klouderone/Kiwi36-Split/Kiwi36 PCB Kicad Files/kiwi_36.kicad_sch

## KiCad design Kiwi36 PCB Kicad Files/kiwi_36.kicad_sch (2025-06-20)

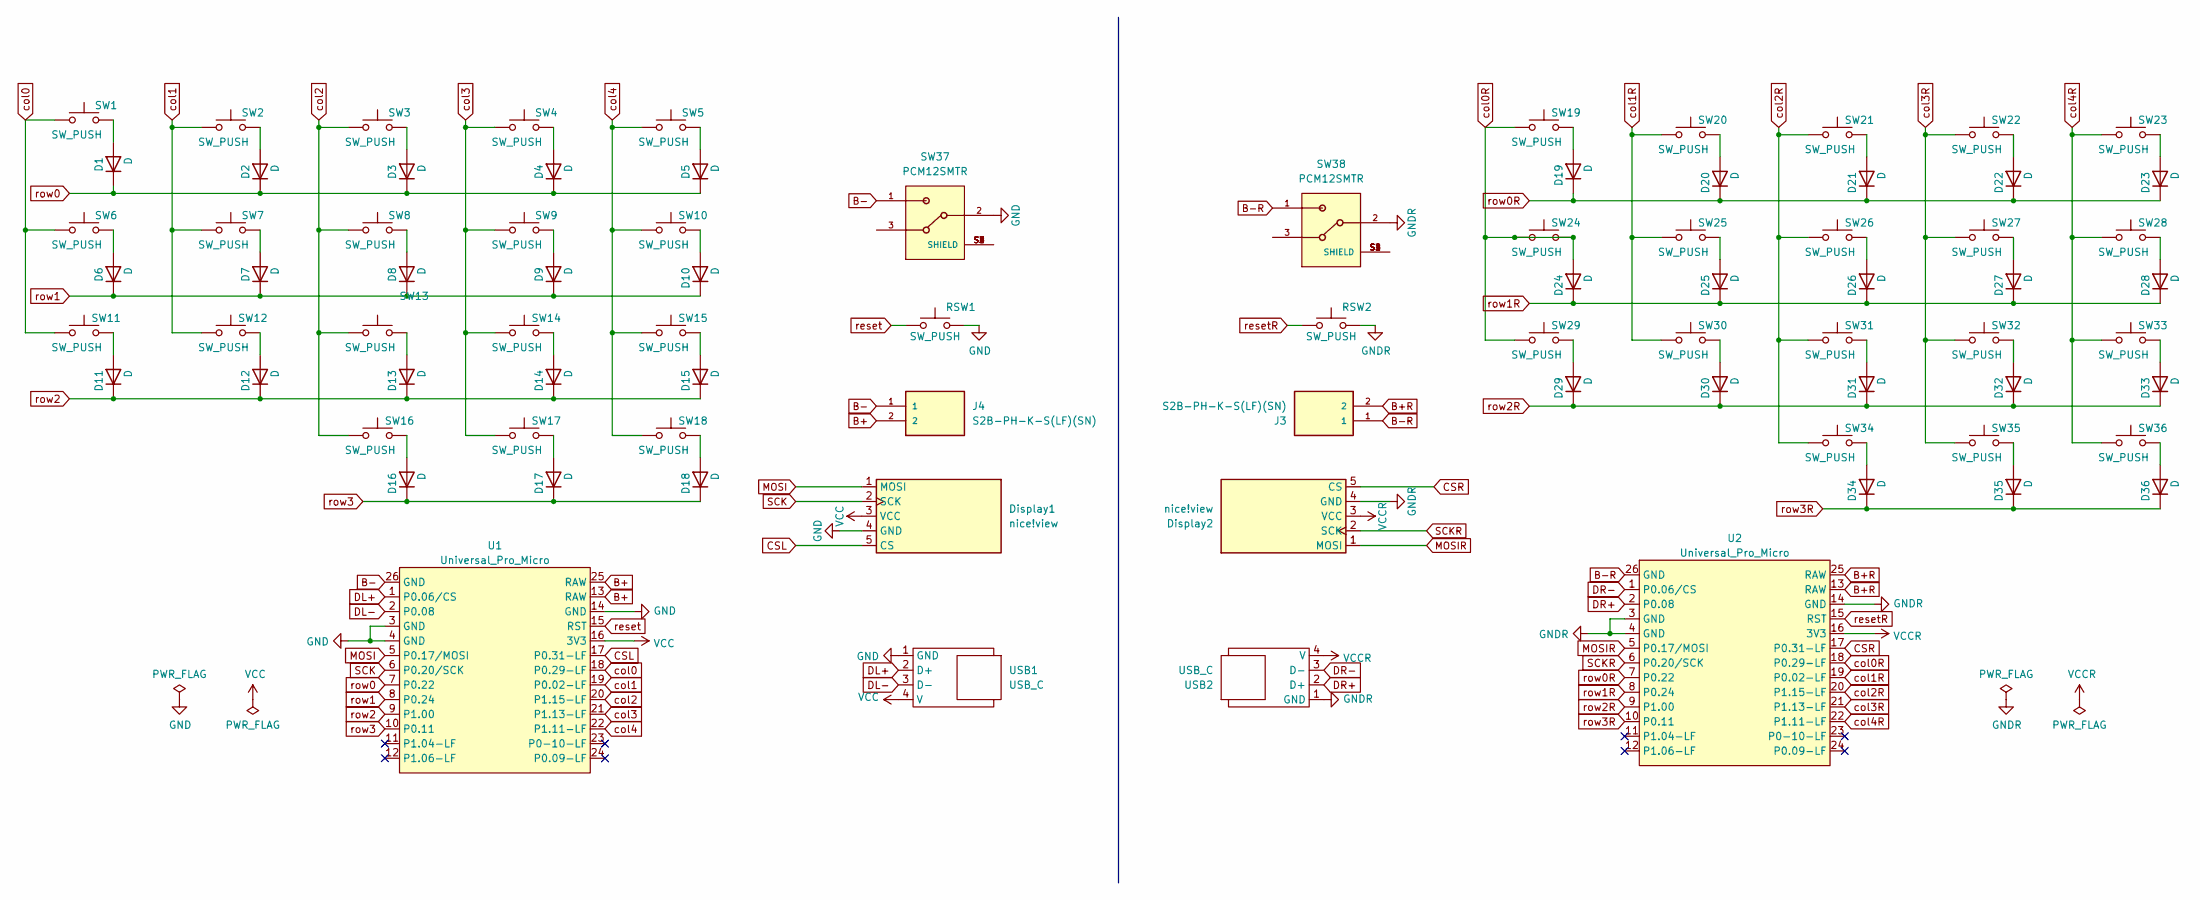
[picture p1: schematic kiwi_36.kicad_sch]

Parts:
D1, D2, D3, D4, D5, D6, D7, D8, D9, D10, D11, D12, D13, D14, D15, D16, D17, D18, D19, D20, D21, D22, D23, D24, D25, D26, D27, D28, D29, D30, D31, D32, D33, D34, D35, D36: D; SMD SOD123 and Leaded
Display1, Display2: nice!view; nice_view
J3, J4: S2B-PH-K-S(LF)(SN); PH_S2B-PH2-K_1x02_P2.00mm_Horizontal
RSW1, RSW2: SW_PUSH; ResetSW_1side
SW1, SW2, SW3, SW4, SW5, SW6, SW7, SW8, SW9, SW10, SW11, SW12, SW13, SW14, SW15, SW16, SW17, SW18, SW19, SW20, SW21, SW22, SW23, SW24, SW25, SW26, SW27, SW28, SW29, SW30, SW31, SW32, SW33, SW34, SW35, SW36: SW_PUSH; SW_MXchocGLP_HS_1u
SW37, SW38: PCM12SMTR; MSK-12C02 Toggle Switch
U1, U2: Universal_Pro_Micro; Universal_Pro_Micro_Footprint
USB1, USB2: USB_C; USB C Daugher Board

Connections:
B+: J4.2, U1.13 (RAW), U1.25 (RAW)
B+R: J3.2, U2.13 (RAW), U2.25 (RAW)
B-: J4.1, SW37.1, U1.26 (GND)
B-R: J3.1, SW38.1, U2.26 (GND)
CSL: Display1.5 (CS), U1.17 (P0.31-LF)
CSR: Display2.5 (CS), U2.17 (P0.31-LF)
DL+: U1.1 (P0.06/CS), USB1.2 (D+)
DL-: U1.2 (P0.08), USB1.3 (D-)
DR+: U2.2 (P0.08), USB2.2 (D+)
DR-: U2.1 (P0.06/CS), USB2.3 (D-)
GND: Display1.4 (GND), RSW1.2, SW37.2, U1.3 (GND), U1.4 (GND), U1.14 (GND), USB1.1 (GND)
GNDR: Display2.4 (GND), RSW2.2, SW38.2, U2.3 (GND), U2.4 (GND), U2.14 (GND), USB2.1 (GND)
MOSI: Display1.1 (MOSI), U1.5 (P0.17/MOSI)
MOSIR: Display2.1 (MOSI), U2.5 (P0.17/MOSI)
unnamed: D1.2 (A), SW1.2
unnamed: D2.2 (A), SW2.2
unnamed: D3.2 (A), SW3.2
unnamed: D4.2 (A), SW4.2
unnamed: D5.2 (A), SW5.2
unnamed: D6.2 (A), SW6.2
unnamed: D7.2 (A), SW7.2
unnamed: D8.2 (A), SW8.2
unnamed: D9.2 (A), SW9.2
unnamed: D10.2 (A), SW10.2
unnamed: D11.2 (A), SW11.2
unnamed: D12.2 (A), SW12.2
unnamed: D13.2 (A), SW13.2
unnamed: D14.2 (A), SW14.2
unnamed: D15.2 (A), SW15.2
unnamed: D16.2 (A), SW16.2
unnamed: D17.2 (A), SW17.2
unnamed: D18.2 (A), SW18.2
unnamed: D19.2 (A), SW19.2
unnamed: D20.2 (A), SW20.2
unnamed: D21.2 (A), SW21.2
unnamed: D22.2 (A), SW22.2
unnamed: D23.2 (A), SW23.2
unnamed: D25.2 (A), SW25.2
unnamed: D26.2 (A), SW26.2
unnamed: D27.2 (A), SW27.2
unnamed: D28.2 (A), SW28.2
unnamed: D29.2 (A), SW29.2
unnamed: D30.2 (A), SW30.2
unnamed: D31.2 (A), SW31.2
unnamed: D32.2 (A), SW32.2
unnamed: D33.2 (A), SW33.2
unnamed: D34.2 (A), SW34.2
unnamed: D35.2 (A), SW35.2
unnamed: D36.2 (A), SW36.2
unnamed: SW37.S1 (SHIELD), SW37.S2 (SHIELD), SW37.S3 (SHIELD), SW37.S4 (SHIELD)
unnamed: SW38.S1 (SHIELD), SW38.S2 (SHIELD), SW38.S3 (SHIELD), SW38.S4 (SHIELD)
SCK: Display1.2 (SCK), U1.6 (P0.20/SCK)
SCKR: Display2.2 (SCK), U2.6 (P0.20/SCK)
VCC: Display1.3 (VCC), U1.16 (3V3), USB1.4 (V)
VCCR: Display2.3 (VCC), U2.16 (3V3), USB2.4 (V)
col0: SW1.1, SW6.1, SW11.1, U1.18 (P0.29-LF)
col0R: D24.2 (A), SW19.1, SW24.1, SW24.2, SW29.1, U2.18 (P0.29-LF)
col1: SW2.1, SW7.1, SW12.1, U1.19 (P0.02-LF)
col1R: SW20.1, SW25.1, SW30.1, U2.19 (P0.02-LF)
col2: SW3.1, SW8.1, SW13.1, SW16.1, U1.20 (P1.15-LF)
col2R: SW21.1, SW26.1, SW31.1, SW34.1, U2.20 (P1.15-LF)
col3: SW4.1, SW9.1, SW14.1, SW17.1, U1.21 (P1.13-LF)
col3R: SW22.1, SW27.1, SW32.1, SW35.1, U2.21 (P1.13-LF)
col4: SW5.1, SW10.1, SW15.1, SW18.1, U1.22 (P1.11-LF)
col4R: SW23.1, SW28.1, SW33.1, SW36.1, U2.22 (P1.11-LF)
reset: RSW1.1, U1.15 (RST)
resetR: RSW2.1, U2.15 (RST)
row0: D1.1 (K), D2.1 (K), D3.1 (K), D4.1 (K), D5.1 (K), U1.7 (P0.22)
row0R: D19.1 (K), D20.1 (K), D21.1 (K), D22.1 (K), D23.1 (K), U2.7 (P0.22)
row1: D6.1 (K), D7.1 (K), D8.1 (K), D9.1 (K), D10.1 (K), U1.8 (P0.24)
row1R: D24.1 (K), D25.1 (K), D26.1 (K), D27.1 (K), D28.1 (K), U2.8 (P0.24)
row2: D11.1 (K), D12.1 (K), D13.1 (K), D14.1 (K), D15.1 (K), U1.9 (P1.00)
row2R: D29.1 (K), D30.1 (K), D31.1 (K), D32.1 (K), D33.1 (K), U2.9 (P1.00)
row3: D16.1 (K), D17.1 (K), D18.1 (K), U1.10 (P0.11)
row3R: D34.1 (K), D35.1 (K), D36.1 (K), U2.10 (P0.11)
