klouderone/Kiwi36-Split/Firmware/QMK Vial/kiwi36/keymaps/vial/config.h

/*

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
You should have received a copy of the GNU General Public License
along with this program.  If not, see <http://www.gnu.org/licenses/>.
*/

#pragma once

#define VIAL_KEYBOARD_UID {0x3B, 0x6B, 0xA0, 0x29, 0x80, 0x56, 0xED, 0xD1}
#define VIAL_UNLOCK_COMBO_ROWS {0, 0}
#define VIAL_UNLOCK_COMBO_COLS {0, 1}

#define SPLIT_USB_DETECT

#define DYNAMIC_KEYMAP_LAYER_COUNT 4
// #define TAPPING_TERM 180

// #define USE_MATRIX_I2C
#ifdef KEYBOARD_kiwi36
#    undef USE_I2C
#    define USE_SERIAL
#endif

/* Select hand configuration */

// #define MASTER_LEFT
// #define MASTER_RIGHT

#define OLED_Display_128x32

#define SPLIT_POINTING_ENABLE
#define POINTING_DEVICE_RIGHT
#define CIRQUE_PINNACLE_DIAMETER_MM 40
#define POINTING_DEVICE_ROTATION_270
#define CIRQUE_PINNACLE_TAP_ENABLE
#define POINTING_DEVICE_GESTURES_SCROLL_ENABLE
#define POINTING_DEVICE_GESTURES_CURSOR_GLIDE_ENABLE


#ifndef NO_DEBUG
#define NO_DEBUG
#endif // !NO_DEBUG
#if !defined(NO_PRINT) && !defined(CONSOLE_ENABLE)
#define NO_PRINT
#endif // !NO_PRINT
// split config

#define EE_HANDS
#define SERIAL_USART_FULL_DUPLEX   // Enable full duplex operation mode.
#define SERIAL_PIO_USE_PIO1
#define SERIAL_USART_TX_PIN D3     // USART TX pin
#define SERIAL_USART_RX_PIN D2     // USART RX pin
